souri/OpenRobo/Design/base.jpeg

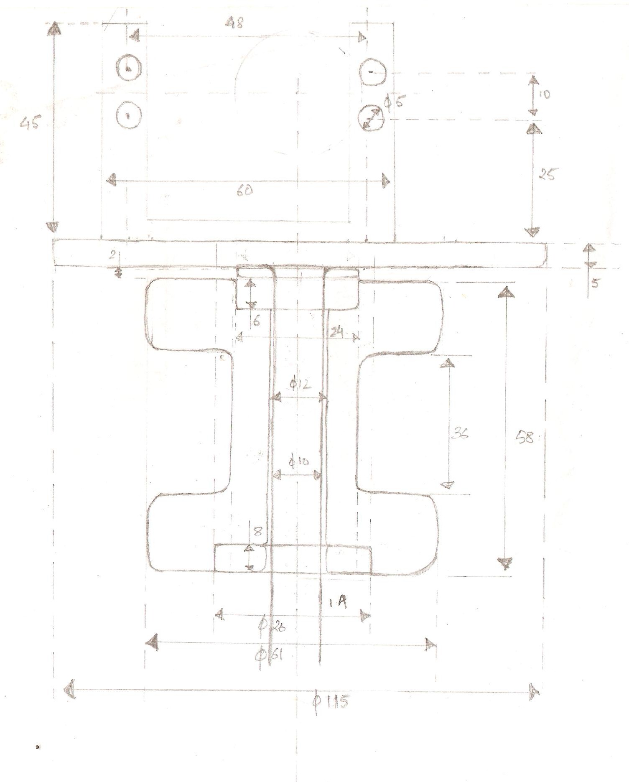
Design/base.jpeg
