souri/OpenRobo/Design/baseidea.jpeg

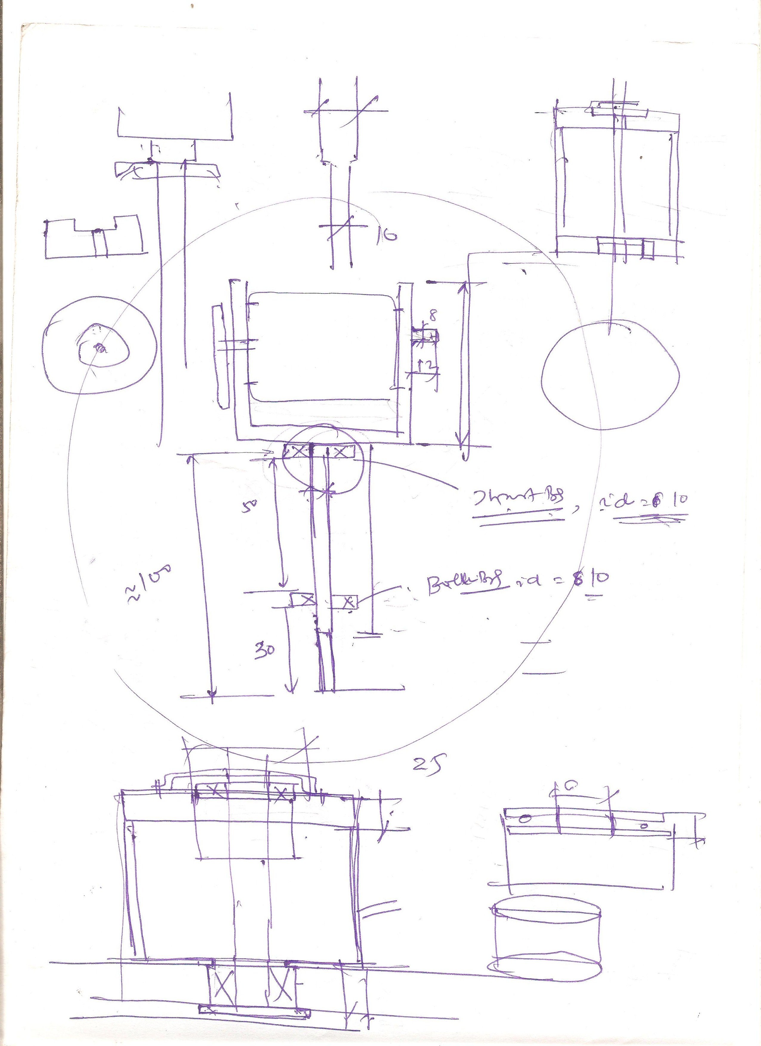
Design/baseidea.jpeg
