souri/OpenRobo/Design/spring databook.jpeg

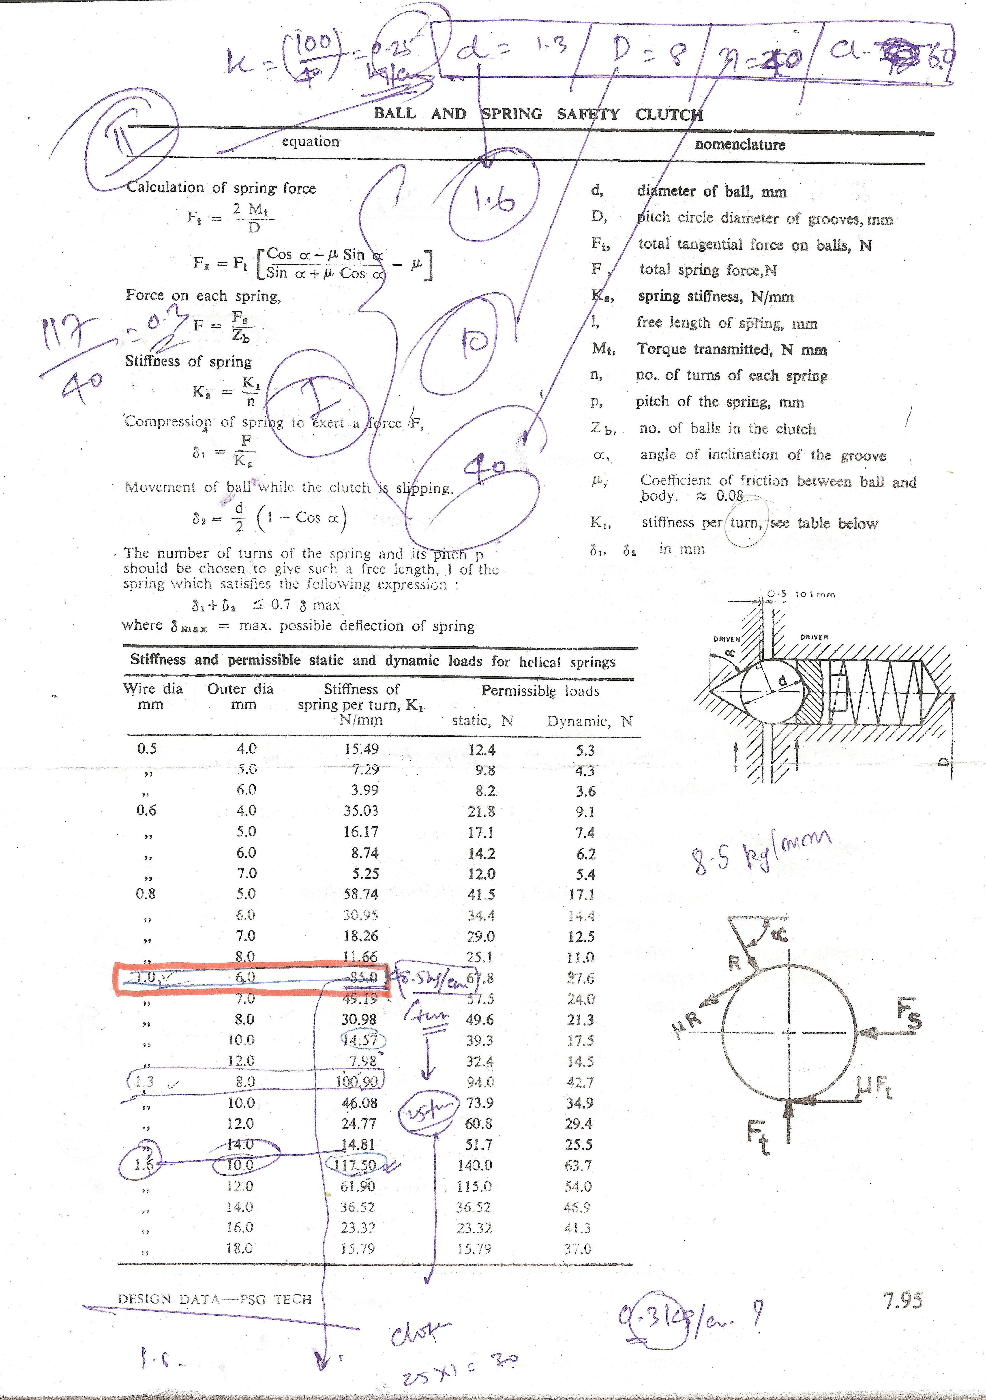
Design/spring databook.jpeg
