souri/OpenRobo/Design/spring design.jpeg

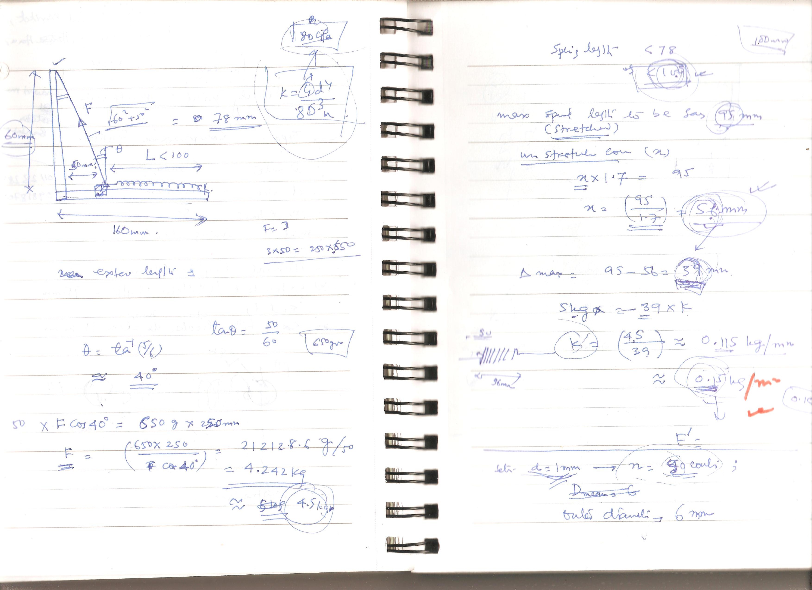
Design/spring design.jpeg
