souri/OpenRobo/Design/spring parameters.jpeg

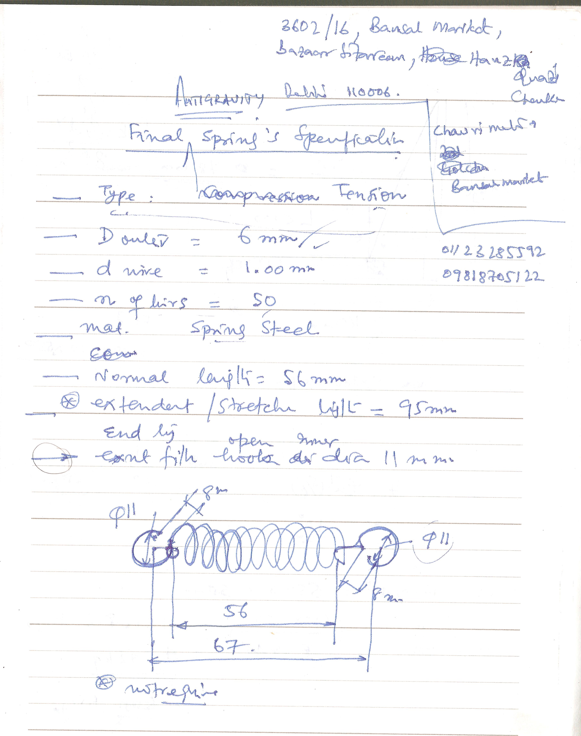
Design/spring parameters.jpeg
