souri/OpenRobo/Design/weightcalc.jpeg

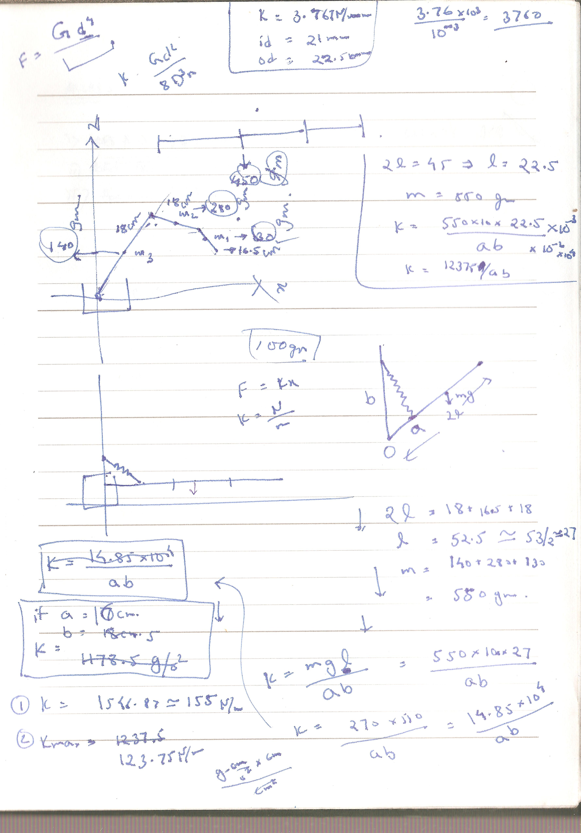
Design/weightcalc.jpeg
