souri/OpenRobo/Inv Kinematics AI Code/Space reach.bmp

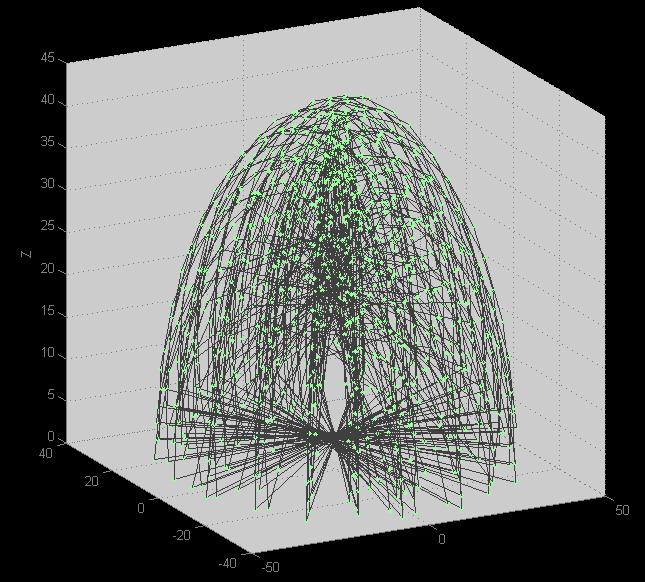
Inv Kinematics AI Code/Space reach.bmp
