souri/OpenRobo/Inv Kinematics AI Code/space.bmp

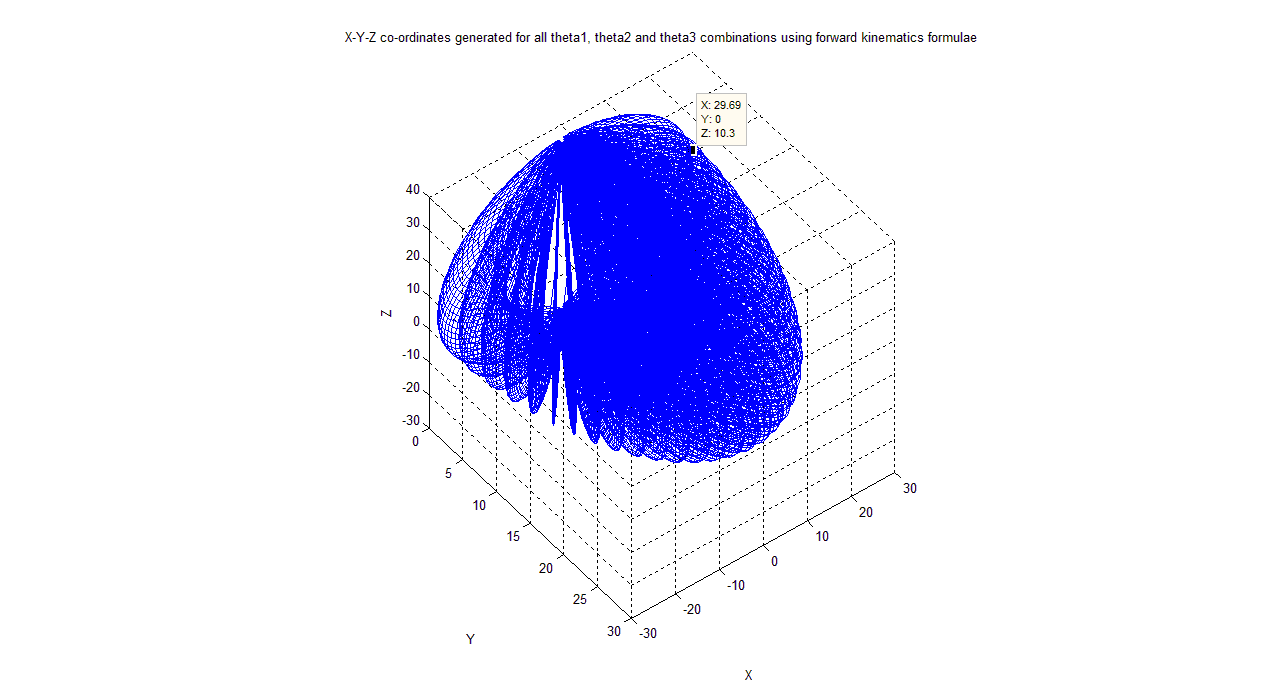
Inv Kinematics AI Code/space.bmp
