souri/OpenRobo/Ref_Docs/pic servo drive.png

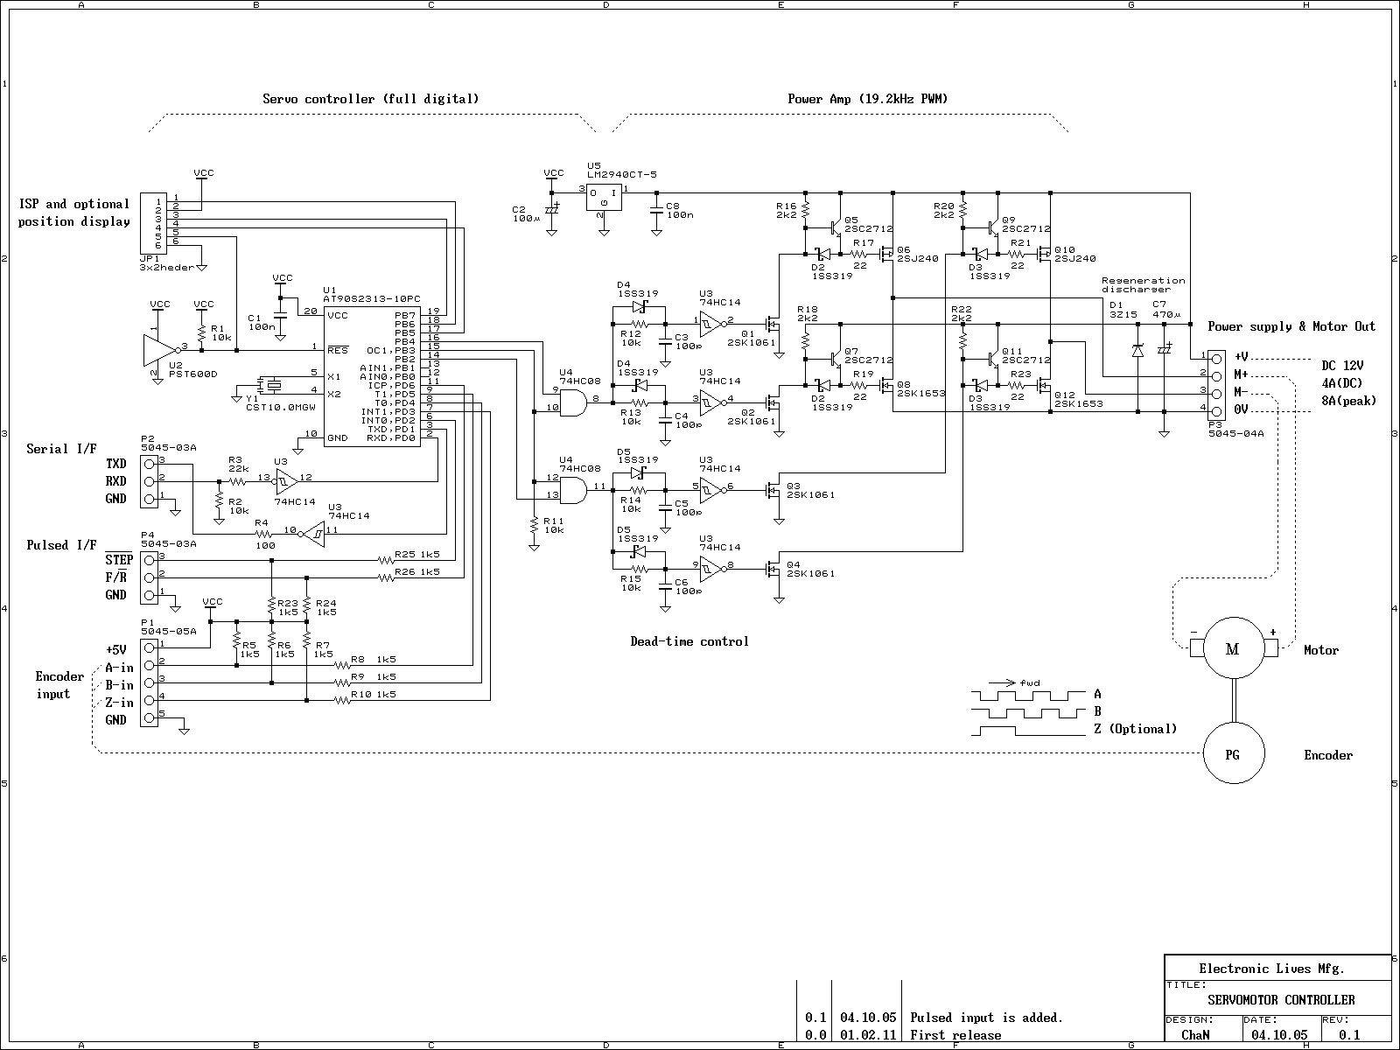
Ref_Docs/pic servo drive.png
