souri/OpenRobo/(list of files, drawings)

Other design files:
Labview Stuff/serial.DSN
Proteus Simulation/OpenRobo_FINAL.DSN
