souri/OpenRobo/(commit log)

2012-10-08 PCB Designs, LABVIEW forward/inverse kinematics + serial interface code, MATLAB ANFIS based inverse kinematics code for the Robot
    [Robot Arm_Souri.brd, Robot Arm_Souri.sch, labview.cfg, serial.DSN]
2013-09-01 - Added design docs - Removed duplicates - Added references - Added trial and test codes - Changed to a more intuitive directory layout - Added Synopis, Project Report
    [OpenRobo_FINAL.DSN, Robot Arm_Souri.brd, Robot Arm_Souri.sch, encoder.cfg, labview.cfg, lcd.cfg, robo.cfg, serial.DSN]
